veazhang/VESC-6/Documentation/pictures/FreeCad.PNG

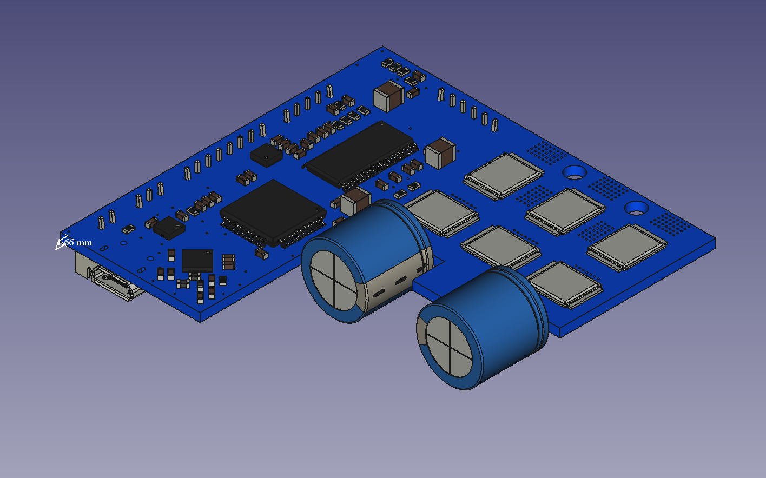
Documentation/pictures/FreeCad.PNG
