veazhang/VESC-6/Documentation/VESC_6.4 BOM.xlsx

Bill of Materials (BOM) - Anti_Spark_Switch
Item # | Qty | Ref Des | Manufacturer | Mfg Part # | Dist. Part # | Price Per Unit | Total Price | Description | Package | Type | Datasheet | Notes
1 | 3 | Q1,Q2,Q3 | Infineon Technologies | IRFS7530TRL7PP | 942-IRFS7530TRL7PP | $3.65 | $10.95 | Power MOSFET | D2PAK-7 | SMD | http://www.mouser.com/ds/2/196/irfs7530-7ppbf-937822.pdf
2 | 2 | R1,R2 | Panasonic | ERJ-3EKF1004V | 667-ERJ-3EKF1004V | $0.15 | $0.30 | 1M Resistor | 0603 | SMD | http://www.mouser.com/ds/2/315/AOA0000C86-911473.pdf
3 | 1 | R3 | Panasonic | ERJ-3EKF1001V | 667-ERJ-3EKF1001V | $0.15 | $0.15 | 1K Resistor | 0603 | SMD
4 | 1 | C1 | AVX | 06033C105KAT2A | 581-06033C105KAT2A | $0.11 | $0.11 | 1uF Capacitor | 0603 | SMD
5 | 1 | D1 | Taiwan Semiconductor | BZT52B12 | 821-BZT52B12 | $0.15 | $0.15 | 12V Zener Diode | SOD-123 | SMD
5 | 2 | P3,P4 | Wurth Electronics | 7460408 | 710-7460408 | $3.89 | $7.78 | M5 Threaded Power Terminal | M5 Thread | Thru Hole | http://www.mouser.com/ds/2/445/7460408-538106.pdf
5 | 1 | F1 | Littelfuse | 142.5631.5702 | 576-142.5631.5702 | $7.25 | $7.25 | 70A Slow Blow Auto Fuse | Fuse | Bolt Down | http://www.mouser.com/ds/2/240/Littelfuse_BF1_58V_Datasheet-523203.pdf
 |  |  |  |  | Board Multiplier: | 1 | Mainboard Total:
 |  |  |  |  |  |  | $26.69
 |  |  |  |  |  |  | Grand Total:
 |  |  |  |  |  |  | $26.69
