veazhang/VESC-6/Documentation/MCAD/Space-Drive-MCAD.FCStd

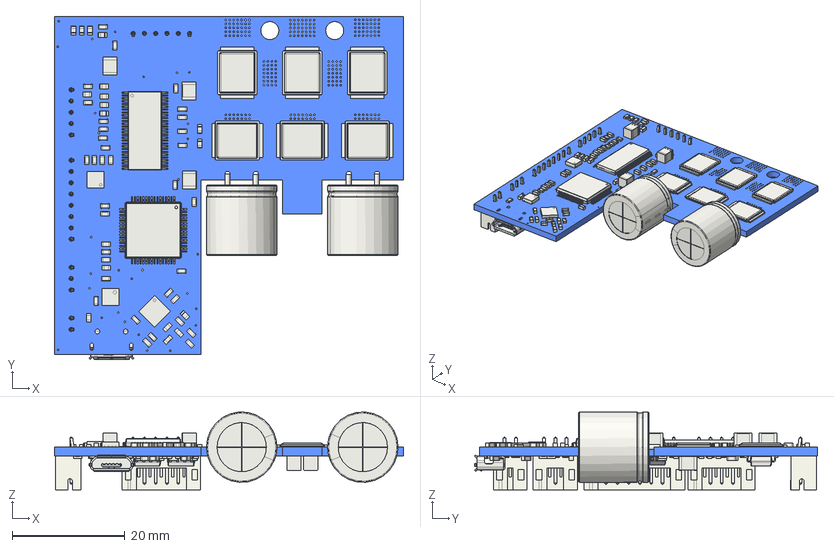
[picture p9: CAD file, 2018-04-09]
Documentation/MCAD/Space-Drive-MCAD.FCStd
62.0 x 60.8 x 13.8 mm
Pcb
CP_Radial_D125mm_P500mm_
CP_Radial_D125mm_P500mm_001
HTSSOP_56_1EP_61x14mm_Pitch05mm_
C_0603_
C_0603_001
C_0603_002
C_0603_003
C_0603_008
C_0603_009
C_0603_010
C_0603_011
C_0603_013
C_0603_014
C_0603_015
C_0603_016
C_0603_017
C_0603_019
C_0603_020
C_1210_
C_0603_022
C_0603_023
C_0603_024
C_0603_025
C_0603_026
C_1210_002
C_0603_027
C_1210_003
C_0603_032
C_0603_035
C_0603_036
C_0603_037
C_0603_038
C_0603_039
C_0603_042
C_0603_043
C_0603_044
C_0603_045
C_0603_046
C_0603_047
C_0603_048
C_0603_049
L_0603_
L_0603_001
L_0603_002
DirectFET_L8_
DirectFET_L8_001
DirectFET_L8_002
DirectFET_L8_003
DirectFET_L8_004
DirectFET_L8_005
R_0603_
R_0603_001
R_0603_002
R_0603_006
R_0603_007
R_0603_011
R_0603_012
R_0603_013
R_0603_014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
