veazhang/VESC-6/(list of files, cad)

Other CAD files:
VESC_6_4.FCStd
