veazhang/VESC-6/VESC_6.4.kicad_pcb

## KiCad design VESC_6.4.kicad_pcb (2018-04-19)

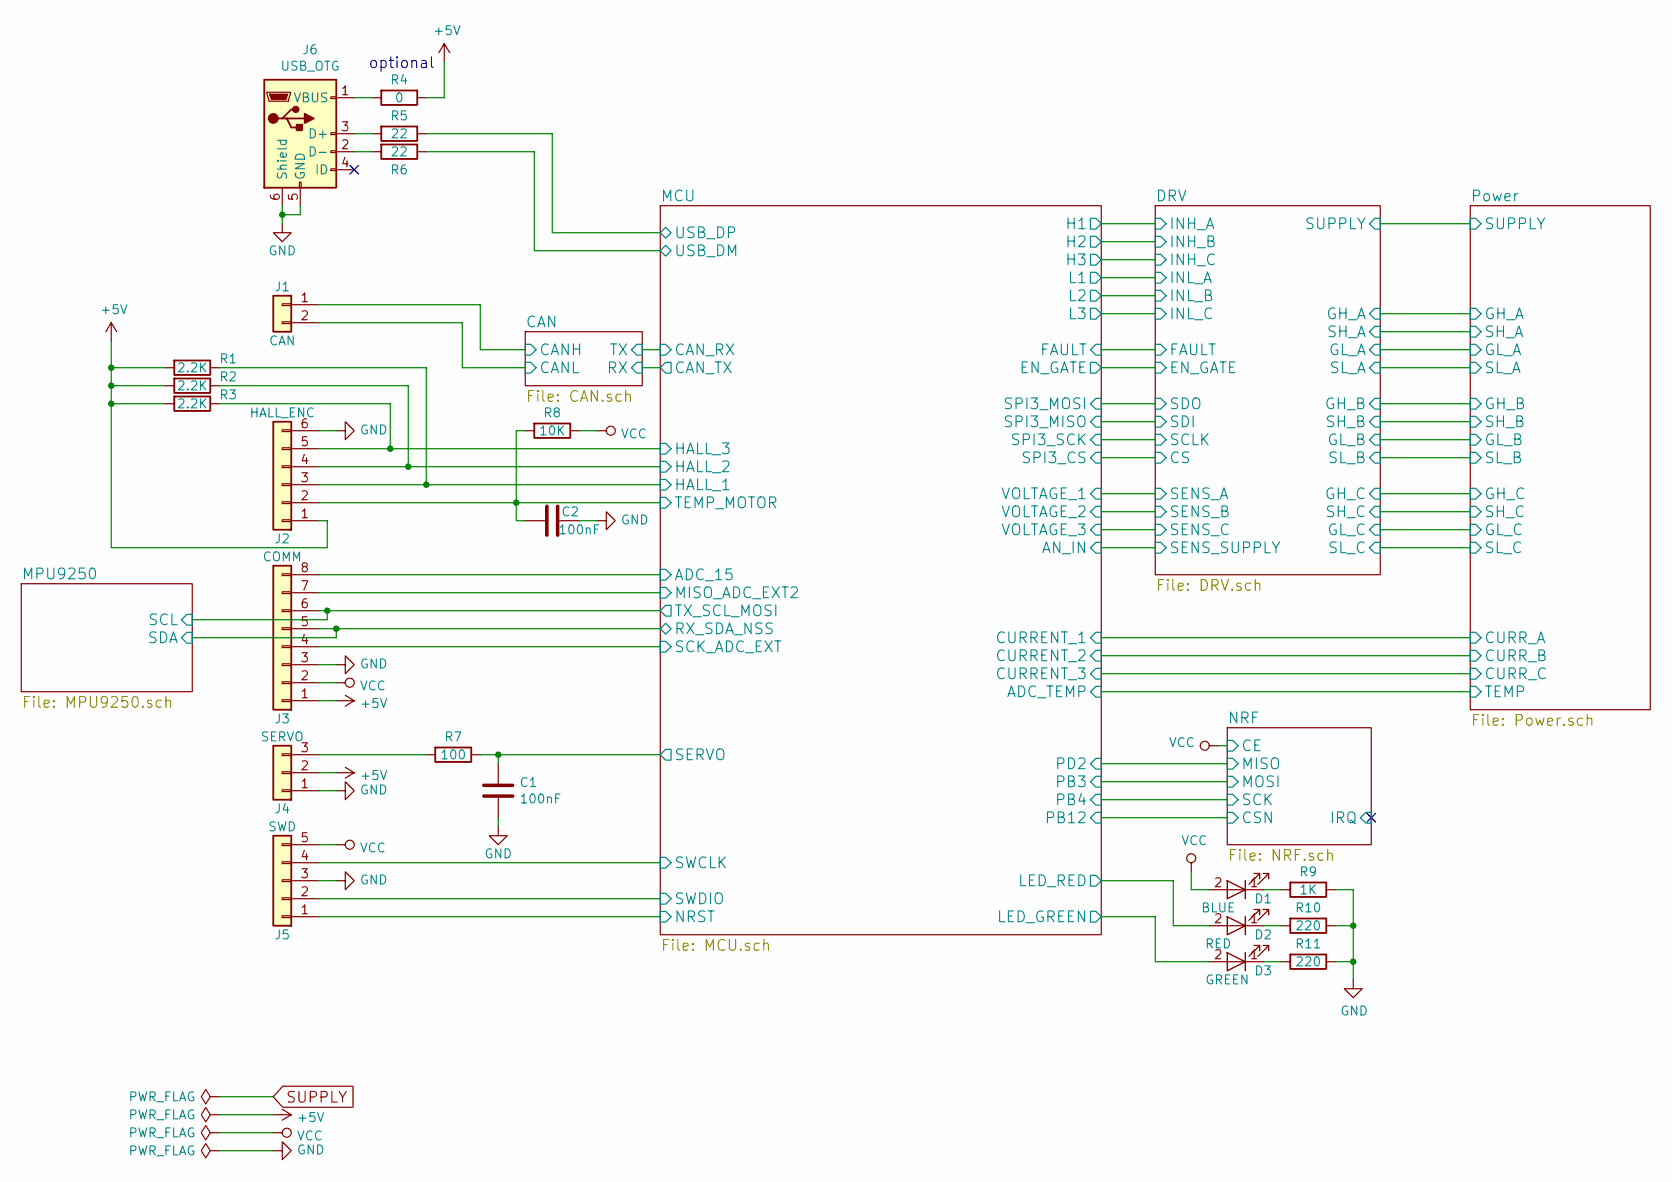
[picture p10: schematic VESC_6.4.sch, VESC 6.4]

Parts:
C1, C2: 100nF; C_0603
D1: BLUE; LED_0603
D2: RED; LED_0603
D3: GREEN; LED_0603
J1: CAN; JST_PH_B2B-PH-K_02x2.00mm_Straight
J2: HALL_ENC; JST_PH_B6B-PH-K_06x2.00mm_Straight
J3: COMM; JST_PH_B8B-PH-K_08x2.00mm_Straight
J4: SERVO; JST_PH_B3B-PH-K_03x2.00mm_Straight
J5: SWD; JST_PH_B5B-PH-K_05x2.00mm_Straight
J6: USB_OTG; USB_Micro-B_Molex-105017-0001
R1, R2, R3: 2.2K; R_0603
R4: 0; R_0603
R5, R6: 22; R_0603
R7: 100; R_0603
R8: 10K; R_0603
R9: 1K; R_0603
R10, R11: 220; R_0603

Connections:
+5V: J2.1, J3.1, J4.2, R1.2, R2.2, R3.2, R4.1; also elsewhere on the board
/CAN/CANH: J1.1; also elsewhere on the board
/CAN/CANL: J1.2; also elsewhere on the board
/MCU/ADC_15: J3.8; also elsewhere on the board
/MCU/HALL_1: J2.3, R1.1; also elsewhere on the board
/MCU/HALL_2: J2.4, R2.1; also elsewhere on the board
/MCU/HALL_3: J2.5, R3.1; also elsewhere on the board
/MCU/LED_GREEN: D3.2 (A); also elsewhere on the board
/MCU/LED_RED: D2.2 (A); also elsewhere on the board
/MCU/MISO_ADC_EXT2: J3.7; also elsewhere on the board
/MCU/NRST: J5.1; also elsewhere on the board
/MCU/RX_SDA_NSS: J3.5; also elsewhere on the board
/MCU/SCK_ADC_EXT: J3.4; also elsewhere on the board
/MCU/SERVO: C1.1, R7.1; also elsewhere on the board
/MCU/SWCLK: J5.4; also elsewhere on the board
/MCU/SWDIO: J5.2; also elsewhere on the board
/MCU/TEMP_MOTOR: C2.1, J2.2, R8.2; also elsewhere on the board
/MCU/USB_DM: R6.1; also elsewhere on the board
/MCU/USB_DP: R5.1; also elsewhere on the board
/MPU9250/SCL: J3.6; also elsewhere on the board
GND: C1.2, C2.2, J2.6, J3.3, J4.1, J5.3, J6.5 (GND), J6.6 (Shield), R9.1, R10.1, R11.1; also elsewhere on the board
unnamed: D1.1 (K), R9.2
unnamed: D2.1 (K), R10.2
unnamed: D3.1 (K), R11.2
unnamed: J4.3, R7.2
unnamed: J6.1 (VBUS), R4.2
unnamed: J6.2 (D-), R6.2
unnamed: J6.3 (D+), R5.2
VCC: D1.2 (A), J3.2, J5.5, R8.1; also elsewhere on the board

Notes on the sheet:
optional

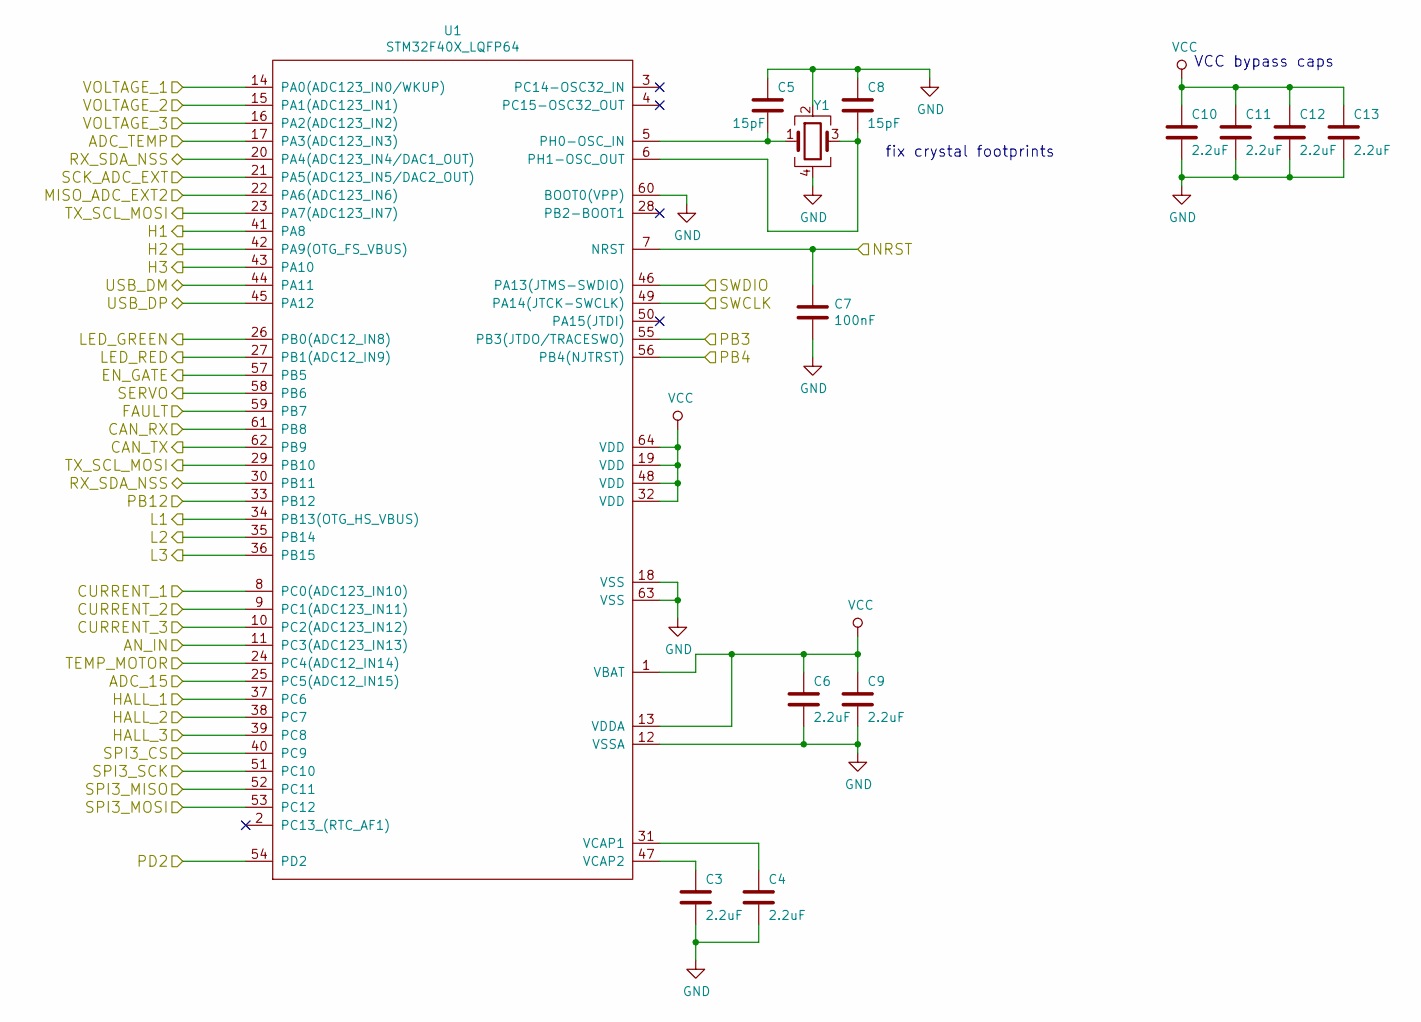
[picture p11: schematic MCU.sch, VESC 6.4]

Parts:
C3, C4, C6, C9, C10, C11, C12, C13: 2.2uF; C_0603
C5, C8: 15pF; C_0603
C7: 100nF; C_0603
U1: STM32F40X_LQFP64; LQFP-64_10x10mm_Pitch0.5mm
Y1: Crystal_GND3; Crystal_SMD_Abracon_ABM3B-4pin_5.0x3.2mm

Connections:
/DRV/CS: U1.40 (PC9); also elsewhere on the board
/DRV/EN_GATE: U1.57 (PB5); also elsewhere on the board
/DRV/FAULT: U1.59 (PB7); also elsewhere on the board
/DRV/INL_A: U1.34 (PB13(OTG_HS_VBUS)); also elsewhere on the board
/DRV/INL_B: U1.35 (PB14); also elsewhere on the board
/DRV/INL_C: U1.36 (PB15); also elsewhere on the board
/DRV/SCLK: U1.51 (PC10); also elsewhere on the board
/DRV/SDI: U1.52 (PC11); also elsewhere on the board
/DRV/SDO: U1.53 (PC12); also elsewhere on the board
/DRV/SENS_A: U1.14 (PA0(ADC123_IN0/WKUP)); also elsewhere on the board
/DRV/SENS_B: U1.15 (PA1(ADC123_IN1)); also elsewhere on the board
/DRV/SENS_C: U1.16 (PA2(ADC123_IN2)); also elsewhere on the board
/MCU/ADC_15: U1.25 (PC5(ADC12_IN15)); also elsewhere on the board
/MCU/ADC_TEMP: U1.17 (PA3(ADC123_IN3)); also elsewhere on the board
/MCU/AN_IN: U1.11 (PC3(ADC123_IN13)); also elsewhere on the board
/MCU/CAN_RX: U1.61 (PB8); also elsewhere on the board
/MCU/CAN_TX: U1.62 (PB9); also elsewhere on the board
/MCU/CURRENT_1: U1.8 (PC0(ADC123_IN10)); also elsewhere on the board
/MCU/CURRENT_2: U1.9 (PC1(ADC123_IN11)); also elsewhere on the board
/MCU/CURRENT_3: U1.10 (PC2(ADC123_IN12)); also elsewhere on the board
/MCU/H1: U1.41 (PA8); also elsewhere on the board
/MCU/H2: U1.42 (PA9(OTG_FS_VBUS)); also elsewhere on the board
/MCU/H3: U1.43 (PA10); also elsewhere on the board
/MCU/HALL_1: U1.37 (PC6); also elsewhere on the board
/MCU/HALL_2: U1.38 (PC7); also elsewhere on the board
/MCU/HALL_3: U1.39 (PC8); also elsewhere on the board
/MCU/LED_GREEN: U1.26 (PB0(ADC12_IN8)); also elsewhere on the board
/MCU/LED_RED: U1.27 (PB1(ADC12_IN9)); also elsewhere on the board
/MCU/MISO_ADC_EXT2: U1.22 (PA6(ADC123_IN6)); also elsewhere on the board
/MCU/NRST: C7.1, U1.7 (NRST); also elsewhere on the board
/MCU/PB4: U1.56 (PB4(NJTRST)); also elsewhere on the board
/MCU/RX_SDA_NSS: U1.20 (PA4(ADC123_IN4/DAC1_OUT)), U1.30 (PB11); also elsewhere on the board
/MCU/SCK_ADC_EXT: U1.21 (PA5(ADC123_IN5/DAC2_OUT)); also elsewhere on the board
/MCU/SERVO: U1.58 (PB6); also elsewhere on the board
/MCU/SWCLK: U1.49 (PA14(JTCK-SWCLK)); also elsewhere on the board
/MCU/SWDIO: U1.46 (PA13(JTMS-SWDIO)); also elsewhere on the board
/MCU/TEMP_MOTOR: U1.24 (PC4(ADC12_IN14)); also elsewhere on the board
/MCU/USB_DM: U1.44 (PA11); also elsewhere on the board
/MCU/USB_DP: U1.45 (PA12); also elsewhere on the board
/MPU9250/SCL: U1.23 (PA7(ADC123_IN7)), U1.29 (PB10); also elsewhere on the board
/NRF/CSN: U1.33 (PB12); also elsewhere on the board
/NRF/MISO: U1.54 (PD2); also elsewhere on the board
/NRF/MOSI: U1.55 (PB3(JTDO/TRACESWO)); also elsewhere on the board
GND: C3.2, C4.2, C5.1, C6.2, C7.2, C8.1, C9.2, C10.2, C11.2, C12.2, C13.2, U1.12 (VSSA), U1.18 (VSS), U1.60 (BOOT0(VPP)), U1.63 (VSS), Y1.2, Y1.4; also elsewhere on the board
unnamed: C3.1, U1.47 (VCAP2)
unnamed: C4.1, U1.31 (VCAP1)
unnamed: C5.2, U1.5 (PH0-OSC_IN), Y1.1
unnamed: C8.2, U1.6 (PH1-OSC_OUT), Y1.3
VCC: C6.1, C9.1, C10.1, C11.1, C12.1, C13.1, U1.1 (VBAT), U1.13 (VDDA), U1.19 (VDD), U1.32 (VDD), U1.48 (VDD), U1.64 (VDD); also elsewhere on the board

Notes on the sheet:
VCC bypass caps
fix crystal footprints

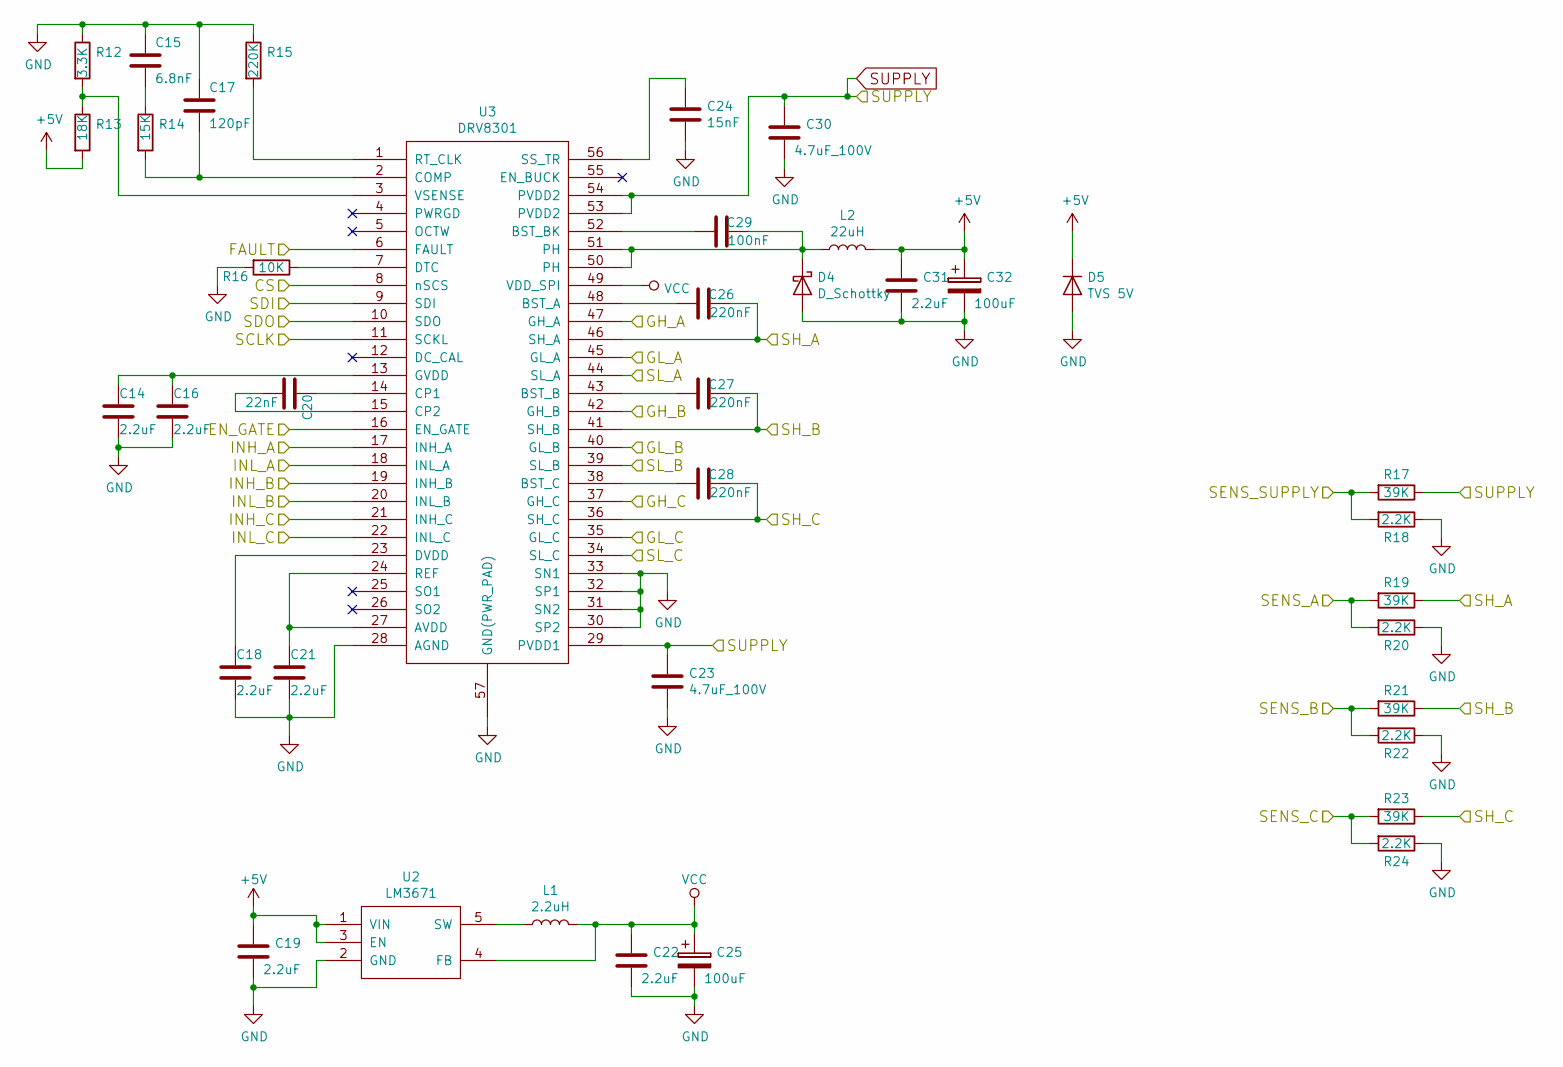
[picture p12: schematic DRV.sch, VESC 6.4]

Parts:
C14, C16, C18, C19, C21, C22, C31: 2.2uF; C_0603
C15: 6.8nF; C_0603
C17: 120pF; C_0603
C20: 22nF; C_0603
C23, C30: 4.7uF_100V; C_1210
C24: 15nF; C_0603
C25, C32: 100uF; C_1210
C26, C27, C28: 220nF; C_0603
C29: 100nF; C_0603
D4: D_Schottky; D_SOD-123
D5: TVS 5V; D_SMA
L1: 2.2uH; L_0805
L2: 22uH; SRN8040
R12: 3.3K; R_0603
R13: 18K; R_0603
R14: 15K; R_0603
R15: 220K; R_0603
R16: 10K; R_0603
R17, R19, R21, R23: 39K; R_0603
R18, R20, R22, R24: 2.2K; R_0603
U2: LM3671; SOT-23-5
U3: DRV8301; 56-HTSSOP

Connections:
+5V: C19.1, C31.1, C32.1, D5.1 (K), L2.2, R13.2, U2.1 (VIN), U2.3 (EN); also elsewhere on the board
/DRV/CS: U3.8 (nSCS); also elsewhere on the board
/DRV/EN_GATE: U3.16 (EN_GATE); also elsewhere on the board
/DRV/FAULT: U3.6 (FAULT); also elsewhere on the board
/DRV/GH_A: U3.47 (GH_A); also elsewhere on the board
/DRV/GH_B: U3.42 (GH_B); also elsewhere on the board
/DRV/GH_C: U3.37 (GH_C); also elsewhere on the board
/DRV/GL_A: U3.45 (GL_A); also elsewhere on the board
/DRV/GL_B: U3.40 (GL_B); also elsewhere on the board
/DRV/GL_C: U3.35 (GL_C); also elsewhere on the board
/DRV/INL_A: U3.18 (INL_A); also elsewhere on the board
/DRV/INL_B: U3.20 (INL_B); also elsewhere on the board
/DRV/INL_C: U3.22 (INL_C); also elsewhere on the board
/DRV/SCLK: U3.11 (SCKL); also elsewhere on the board
/DRV/SDI: U3.9 (SDI); also elsewhere on the board
/DRV/SDO: U3.10 (SDO); also elsewhere on the board
/DRV/SENS_A: R19.2, R20.2; also elsewhere on the board
/DRV/SENS_B: R21.2, R22.2; also elsewhere on the board
/DRV/SENS_C: R23.2, R24.2; also elsewhere on the board
/DRV/SH_A: C26.1, R19.1, U3.46 (SH_A); also elsewhere on the board
/DRV/SH_B: C27.1, R21.1, U3.41 (SH_B); also elsewhere on the board
/DRV/SH_C: C28.1, R23.1, U3.36 (SH_C); also elsewhere on the board
/MCU/AN_IN: R17.2, R18.2; also elsewhere on the board
/MCU/H1: U3.17 (INH_A); also elsewhere on the board
/MCU/H2: U3.19 (INH_B); also elsewhere on the board
/MCU/H3: U3.21 (INH_C); also elsewhere on the board
GND: C14.2, C15.1, C16.2, C17.1, C18.2, C19.2, C21.2, C22.2, C23.2, C24.2, C25.2, C30.2, C31.2, C32.2, D4.2 (A), D5.2 (A), R12.1, R15.1, R16.2, R18.1, R20.1, R22.1, R24.1, U2.2 (GND), U3.28 (AGND), U3.30 (SP2), U3.31 (SN2), U3.32 (SP1), U3.33 (SN1), U3.34 (SL_C), U3.39 (SL_B), U3.44 (SL_A), U3.57 (GND(PWR_PAD)); also elsewhere on the board
unnamed: C14.1, C16.1, U3.13 (GVDD)
unnamed: C15.2, R14.1
unnamed: C17.2, R14.2, U3.2 (COMP)
unnamed: C18.1, U3.23 (DVDD)
unnamed: C20.1, U3.14 (CP1)
unnamed: C20.2, U3.15 (CP2)
unnamed: C21.1, U3.24 (REF), U3.27 (AVDD)
unnamed: C24.1, U3.56 (SS_TR)
unnamed: C26.2, U3.48 (BST_A)
unnamed: C27.2, U3.43 (BST_B)
unnamed: C28.2, U3.38 (BST_C)
unnamed: C29.1, D4.1 (K), L2.1, U3.50 (PH), U3.51 (PH)
unnamed: C29.2, U3.52 (BST_BK)
unnamed: L1.1, U2.5 (SW)
unnamed: R12.2, R13.1, U3.3 (VSENSE)
unnamed: R15.2, U3.1 (RT_CLK)
unnamed: R16.1, U3.7 (DTC)
SUPPLY: C23.1, C30.1, R17.1, U3.29 (PVDD1), U3.53 (PVDD2), U3.54 (PVDD2); also elsewhere on the board
VCC: C22.1, C25.1, L1.2, U2.4 (FB), U3.49 (VDD_SPI); also elsewhere on the board

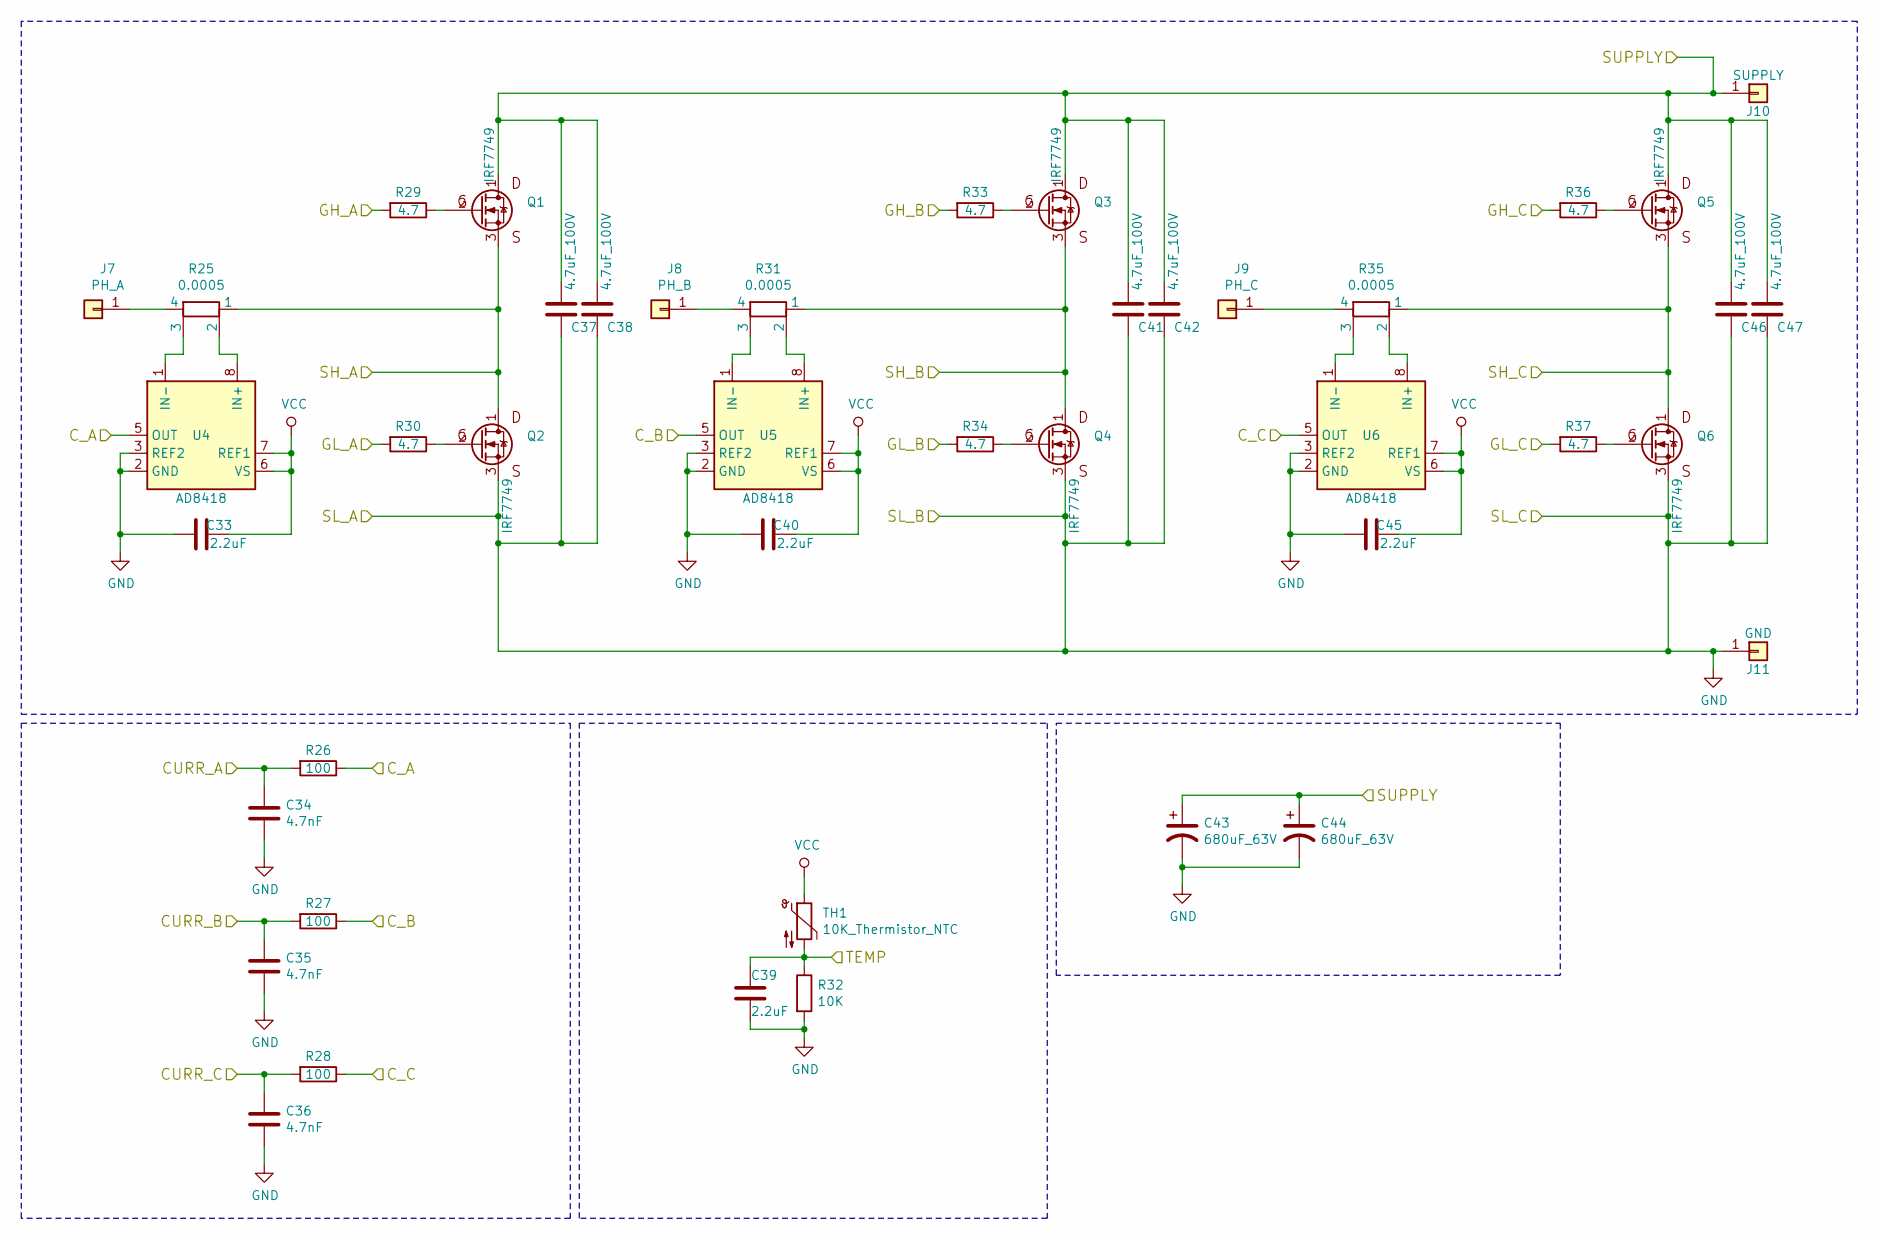
[picture p13: schematic Power.sch, VESC 6.4]

Parts:
C33, C39, C40, C45: 2.2uF; C_0603
C34, C35, C36: 4.7nF; C_0603
C37, C38, C41, C42, C46, C47: 4.7uF_100V; C_1210
C43, C44: 680uF_63V; CP_Radial_D12.5mm_P5.00mm
J7: PH_A; SolderWirePad_single_SMD_5x5mm
J8: PH_B; SolderWirePad_single_SMD_5x5mm
J9: PH_C; SolderWirePad_single_SMD_5x5mm
J10: SUPPLY; SolderWirePad_single_SMD_6.5x6.5mm
J11: GND; SolderWirePad_single_SMD_6.5x6.5mm
Q1, Q2, Q3, Q4, Q5, Q6: IRF7749; DirectFET_L8
R25, R31, R35: 0.0005; 3920
R26, R27, R28: 100; R_0603
R29, R30, R33, R34, R36, R37: 4.7; R_0603
R32: 10K; R_0603
TH1: 10K_Thermistor_NTC; R_0603
U4, U5, U6: AD8418; SOIC-8_3.9x4.9mm_Pitch1.27mm

Connections:
/DRV/GH_A: R29.2; also elsewhere on the board
/DRV/GH_B: R33.2; also elsewhere on the board
/DRV/GH_C: R36.2; also elsewhere on the board
/DRV/GL_A: R30.2; also elsewhere on the board
/DRV/GL_B: R34.2; also elsewhere on the board
/DRV/GL_C: R37.2; also elsewhere on the board
/DRV/SH_A: Q1.3 (S), Q2.1 (D), R25.1; also elsewhere on the board
/DRV/SH_B: Q3.3 (S), Q4.1 (D), R31.1; also elsewhere on the board
/DRV/SH_C: Q5.3 (S), Q6.1 (D), R35.1; also elsewhere on the board
/MCU/ADC_TEMP: C39.1, R32.1, TH1.2; also elsewhere on the board
/MCU/CURRENT_1: C34.1, R26.2; also elsewhere on the board
/MCU/CURRENT_2: C35.1, R27.2; also elsewhere on the board
/MCU/CURRENT_3: C36.1, R28.2; also elsewhere on the board
/Power/C_A: R26.1, U4.5 (OUT)
/Power/C_B: R27.1, U5.5 (OUT)
/Power/C_C: R28.1, U6.5 (OUT)
GND: C33.2, C34.2, C35.2, C36.2, C37.2, C38.2, C39.2, C40.2, C41.2, C42.2, C43.2, C44.2, C45.2, C46.2, C47.2, J11.1, Q2.3 (S), Q4.3 (S), Q6.3 (S), R32.2, U4.2 (GND), U4.3 (REF2), U5.2 (GND), U5.3 (REF2), U6.2 (GND), U6.3 (REF2); also elsewhere on the board
unnamed: J7.1, R25.4
unnamed: J8.1, R31.4
unnamed: J9.1, R35.4
unnamed: Q1.2 (G), R29.1
unnamed: Q2.2 (G), R30.1
unnamed: Q3.2 (G), R33.1
unnamed: Q4.2 (G), R34.1
unnamed: Q5.2 (G), R36.1
unnamed: Q6.2 (G), R37.1
unnamed: R25.2, U4.8 (IN+)
unnamed: R25.3, U4.1 (IN-)
unnamed: R31.2, U5.8 (IN+)
unnamed: R31.3, U5.1 (IN-)
unnamed: R35.2, U6.8 (IN+)
unnamed: R35.3, U6.1 (IN-)
SUPPLY: C37.1, C38.1, C41.1, C42.1, C43.1, C44.1, C46.1, C47.1, J10.1, Q1.1 (D), Q3.1 (D), Q5.1 (D); also elsewhere on the board
VCC: C33.1, C40.1, C45.1, TH1.1, U4.6 (VS), U4.7 (REF1), U5.6 (VS), U5.7 (REF1), U6.6 (VS), U6.7 (REF1); also elsewhere on the board

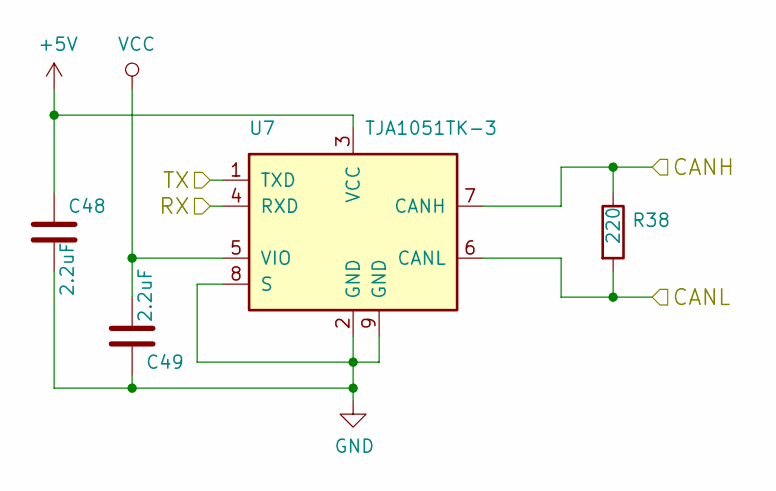
[picture p14: schematic CAN.sch, VESC 6.4]

Parts:
C48, C49: 2.2uF; C_0603
R38: 220; R_0603
U7: TJA1051TK-3; Texas_S-PVSON-N8

Connections:
+5V: C48.1, U7.3 (VCC); also elsewhere on the board
/CAN/CANH: R38.1, U7.7 (CANH); also elsewhere on the board
/CAN/CANL: R38.2, U7.6 (CANL); also elsewhere on the board
/MCU/CAN_RX: U7.1 (TXD); also elsewhere on the board
/MCU/CAN_TX: U7.4 (RXD); also elsewhere on the board
GND: C48.2, C49.2, U7.2 (GND), U7.8 (S), U7.9 (GND); also elsewhere on the board
VCC: C49.1, U7.5 (VIO); also elsewhere on the board

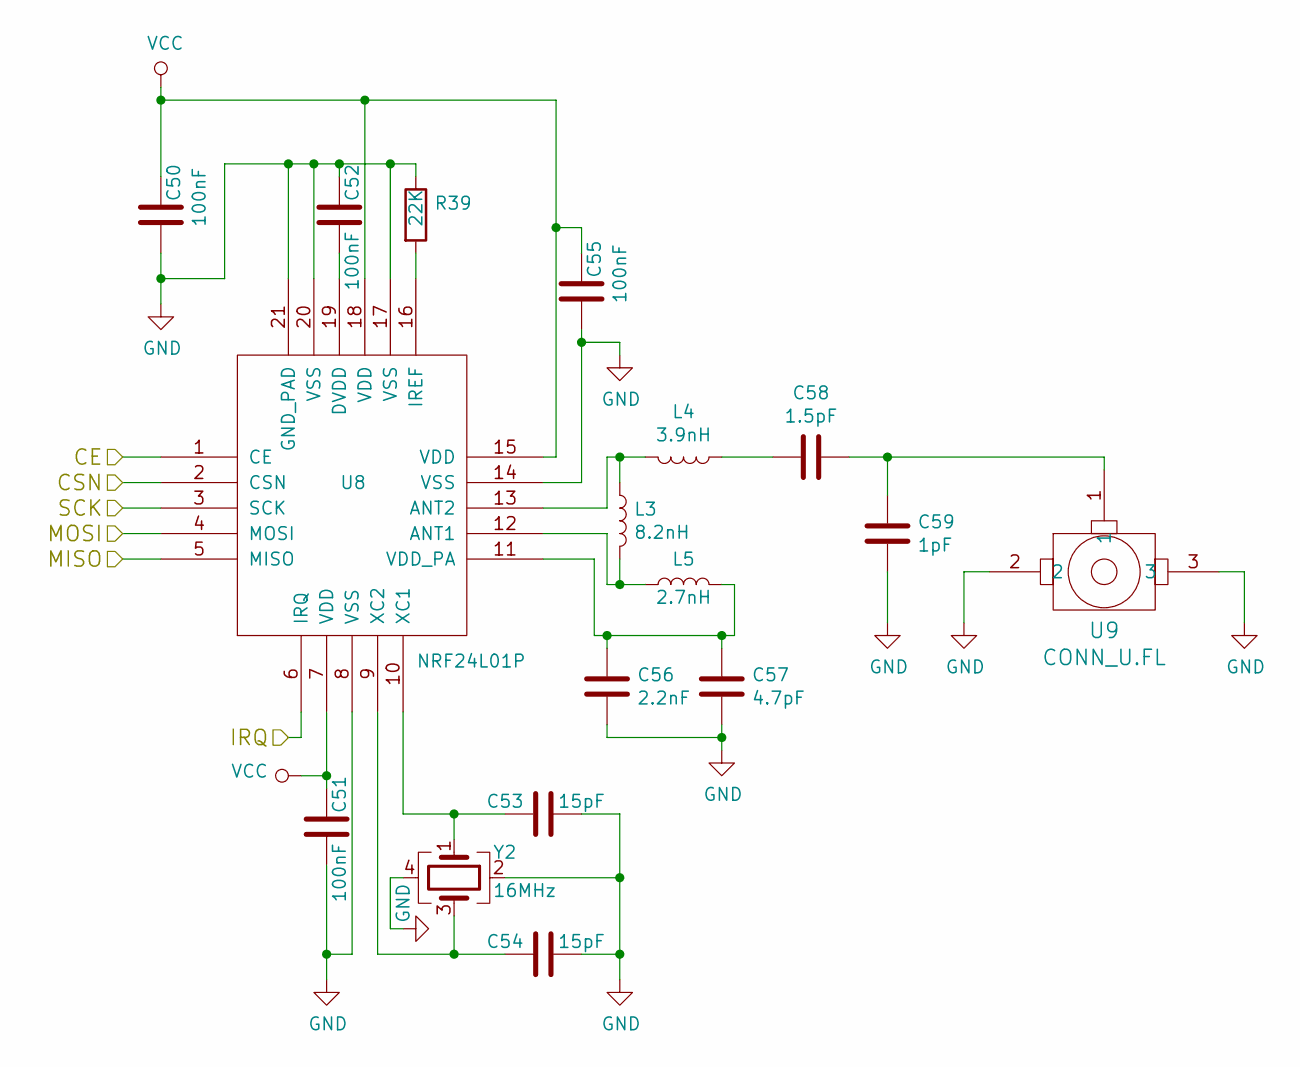
[picture p15: schematic NRF.sch, VESC 6.4]

Parts:
C50, C51, C52, C55: 100nF; C_0603
C53, C54: 15pF; C_0603
C56: 2.2nF; C_0603
C57: 4.7pF; C_0603
C58: 1.5pF; C_0603
C59: 1pF; C_0603
L3: 8.2nH; L_0603
L4: 3.9nH; L_0603
L5: 2.7nH; L_0603
R39: 22K; R_0603
U8: NRF24L01P; QFN-20-1EP_4x4mm_Pitch0.5mm
U9: CONN_U.FL; U.FL-Coax
Y2: 16MHz; Crystal_SMD_Abracon_ABM3B-4pin_5.0x3.2mm

Connections:
/MCU/PB4: U8.3 (SCK); also elsewhere on the board
/NRF/CSN: U8.2 (CSN); also elsewhere on the board
/NRF/IRQ: U8.6 (IRQ)
/NRF/MISO: U8.5 (MISO); also elsewhere on the board
/NRF/MOSI: U8.4 (MOSI); also elsewhere on the board
GND: C50.2, C51.2, C52.1, C53.1, C54.1, C55.2, C56.2, C57.2, C59.2, R39.1, U8.8 (VSS), U8.14 (VSS), U8.17 (VSS), U8.20 (VSS), U8.21 (GND_PAD), U9.2, U9.3, Y2.2, Y2.4; also elsewhere on the board
unnamed: C52.2, U8.19 (DVDD)
unnamed: C53.2, U8.10 (XC1), Y2.1
unnamed: C54.2, U8.9 (XC2), Y2.3
unnamed: C56.1, C57.1, L5.2, U8.11 (VDD_PA)
unnamed: C58.1, C59.1, U9.1
unnamed: C58.2, L4.1
unnamed: L3.1, L4.2, U8.13 (ANT2)
unnamed: L3.2, L5.1, U8.12 (ANT1)
unnamed: R39.2, U8.16 (IREF)
VCC: C50.1, C51.1, C55.1, U8.1 (CE), U8.7 (VDD), U8.15 (VDD), U8.18 (VDD); also elsewhere on the board

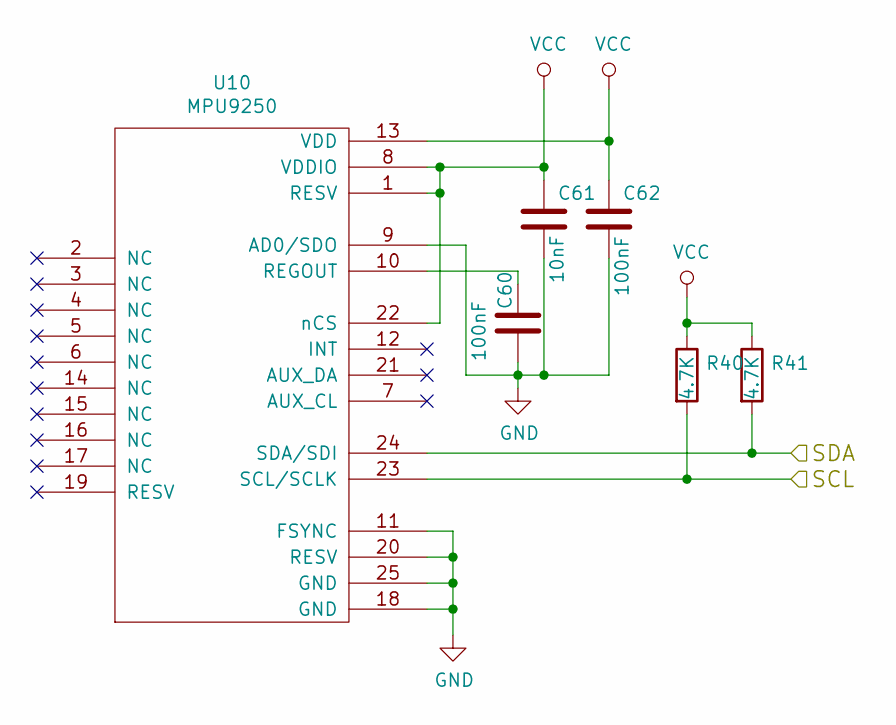
[picture p16: schematic MPU9250.sch]

Parts:
C60, C62: 100nF; C_0603
C61: 10nF; C_0603
R40, R41: 4.7K; R_0603
U10: MPU9250; QFN-24-1EP_3x3mm_Pitch0.4mm

Connections:
/MCU/RX_SDA_NSS: R41.2, U10.24 (SDA/SDI); also elsewhere on the board
/MPU9250/SCL: R40.2, U10.23 (SCL/SCLK); also elsewhere on the board
GND: C60.2, C61.2, C62.2, U10.9 (AD0/SDO), U10.11 (FSYNC), U10.18 (GND), U10.20 (RESV), U10.25 (GND); also elsewhere on the board
unnamed: C60.1, U10.10 (REGOUT)
VCC: C61.1, C62.1, R40.1, R41.1, U10.1 (RESV), U10.8 (VDDIO), U10.13 (VDD), U10.22 (nCS); also elsewhere on the board

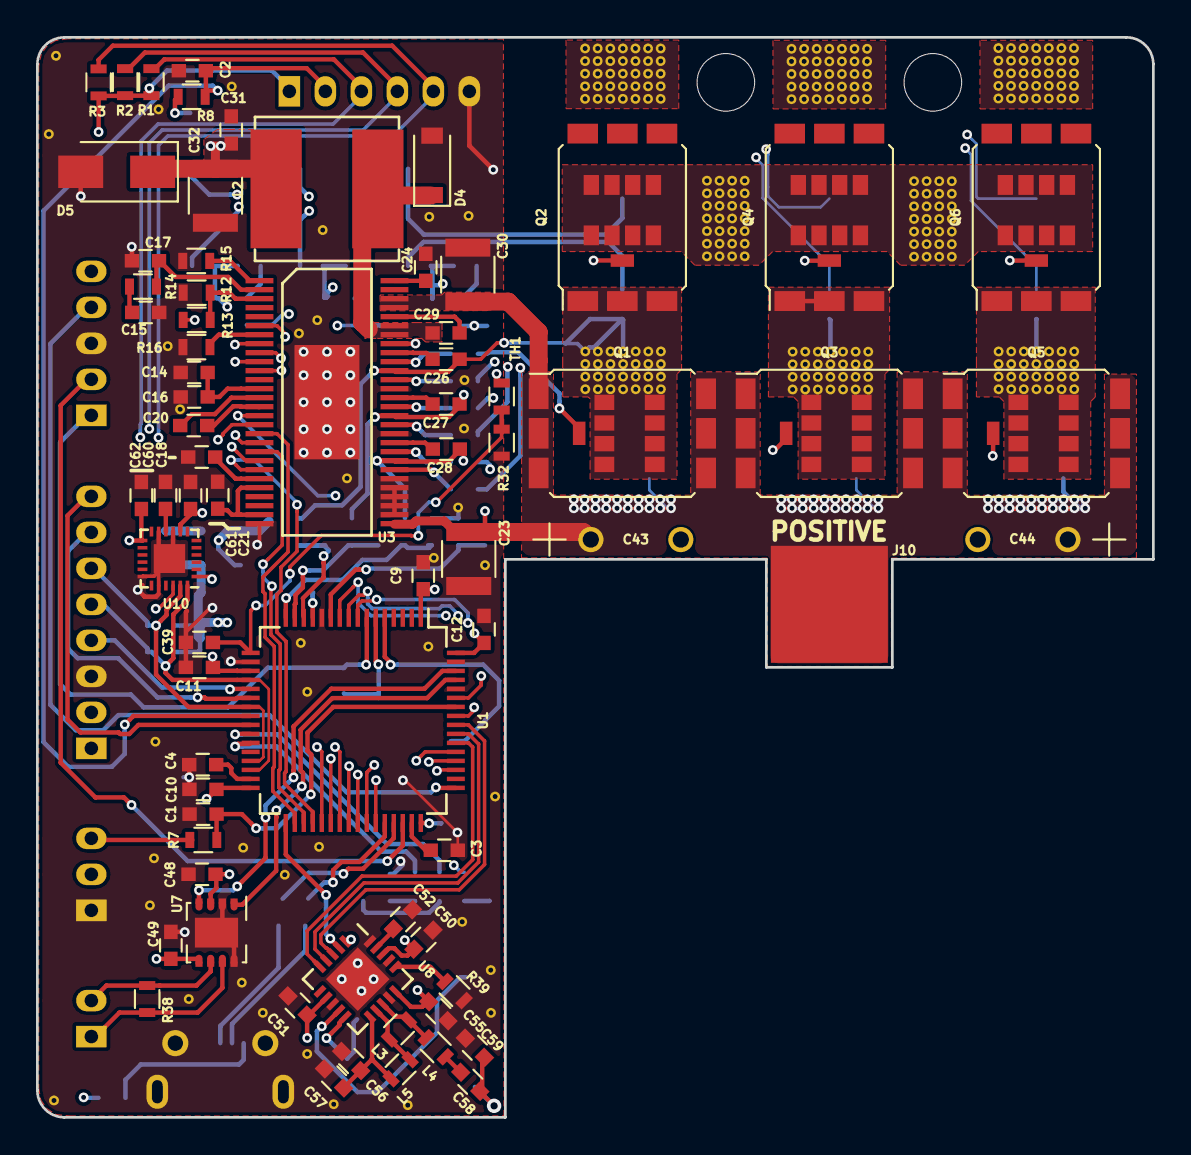
[picture p17: board VESC_6.4.kicad_pcb from above]

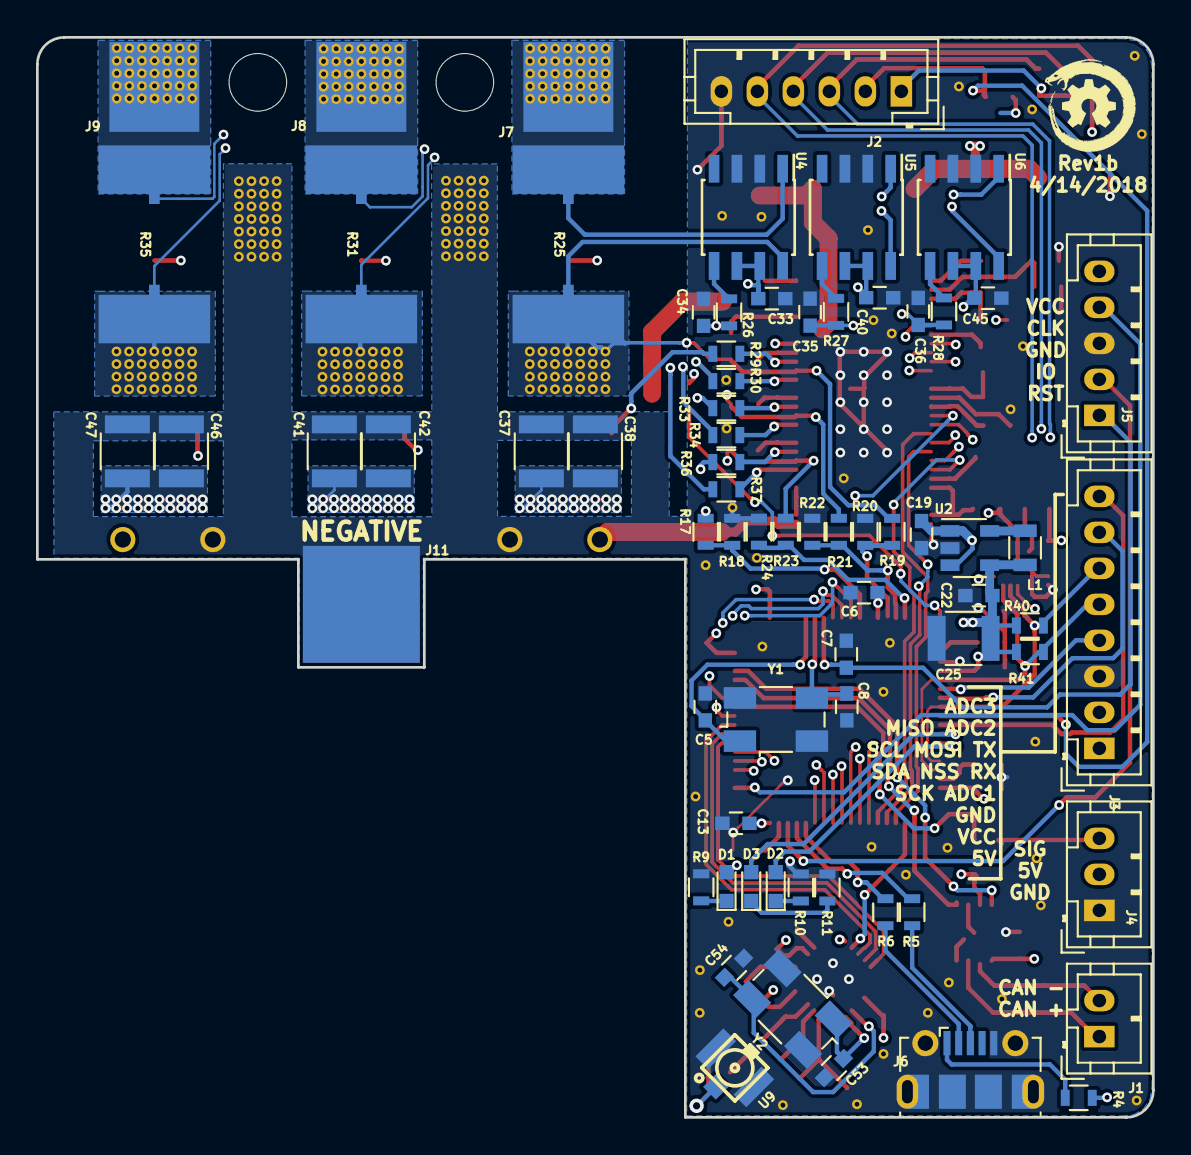
[picture p18: board VESC_6.4.kicad_pcb from below]

Board: 4 copper layers, 62.0 x 60.0 mm, 143 parts (71 on the bottom side), 114 nets.
