veazhang/VESC-6/(commit log)

2018-02-17 initial commit
    schematic completed
    PCB in progress
    [CAN.sch, DRV.sch, MCU.sch, MPU9250.sch, NRF.sch, Power.sch, VESC_6.4 BOM.xlsx, VESC_6.4.kicad_pcb]
2018-02-25 minor PCB work
    [VESC_6.4.kicad_pcb]
2018-02-26 lots of PCB work
    [VESC_6.4.kicad_pcb, VESC_6.4.sch]
2018-02-27 power electronics PCB work
    [VESC_6.4.kicad_pcb]
2018-02-27 Continued Work on the PCB
    [VESC_6.4.kicad_pcb]
2018-02-28 power electronics almost done
    [VESC_6.4.kicad_pcb]
2018-03-02 its a dark and scary night in kicad land
    [VESC_6.4.kicad_pcb]
2018-03-02 the PCB trace gremlins were creeping around
    [VESC_6.4.kicad_pcb]
2018-03-02 the save button tried its hardest to stay safe from the gremlins
    [VESC_6.4.kicad_pcb]
2018-03-02 sometimes the gremlins would delete all of the save buttons work!
    [VESC_6.4.kicad_pcb, _saved_VESC_6.4.sch]
2018-03-02 dun dun dun
    [VESC_6.4.kicad_pcb]
2018-03-02 something ate the power electronics ground plane!
    [VESC_6.4.kicad_pcb]
2018-03-04 Rev1a done
    [VESC_6.4.kicad_pcb]
2018-03-05 changed the USB port around added CAD stuff
    [Power.sch, Space-Drive-MCAD.FCStd, VESC_6.4.kicad_pcb, VESC_6.4.sch, VESC_6_4.FCStd, _saved_VESC_6.4.sch]
2018-03-06 added logo and rev number
    [VESC_6.4.kicad_pcb]
2018-03-28 moved a diode slightly, fixed a DRC issue
    [VESC_6.4.kicad_pcb]
2018-04-08 rounded the PCB corners
    [VESC_6.4.kicad_pcb]
2018-04-09 removed 5v/3v3 sensor switch
    [VESC_6.4.sch]
2018-04-12 removed sensor switch
    [VESC_6.4.sch]
2018-04-12 fixed vias, updated PCB per schematic
    [VESC_6.4.kicad_pcb]
2018-04-19 updated gerbers
    [VESC_6.4-B.Adhes.gbr, VESC_6.4-B.Cu.gbr, VESC_6.4-B.Mask.gbr, VESC_6.4-B.Paste.gbr, VESC_6.4-B.SilkS.gbr, VESC_6.4-Edge.Cuts.gbr, VESC_6.4-F.Adhes.gbr, VESC_6.4-F.Cu.gbr]
2018-04-19 moved files around
    [Space-Drive-MCAD.FCStd]
2018-04-19 silkscreen fixes on PCB
    [VESC_6.4.kicad_pcb]
